icl-rocketry/Ricardo-Gridfins/gridfins/gridfins.kicad_pcb

## KiCad design gridfins/gridfins.kicad_pcb (2026-08-16)

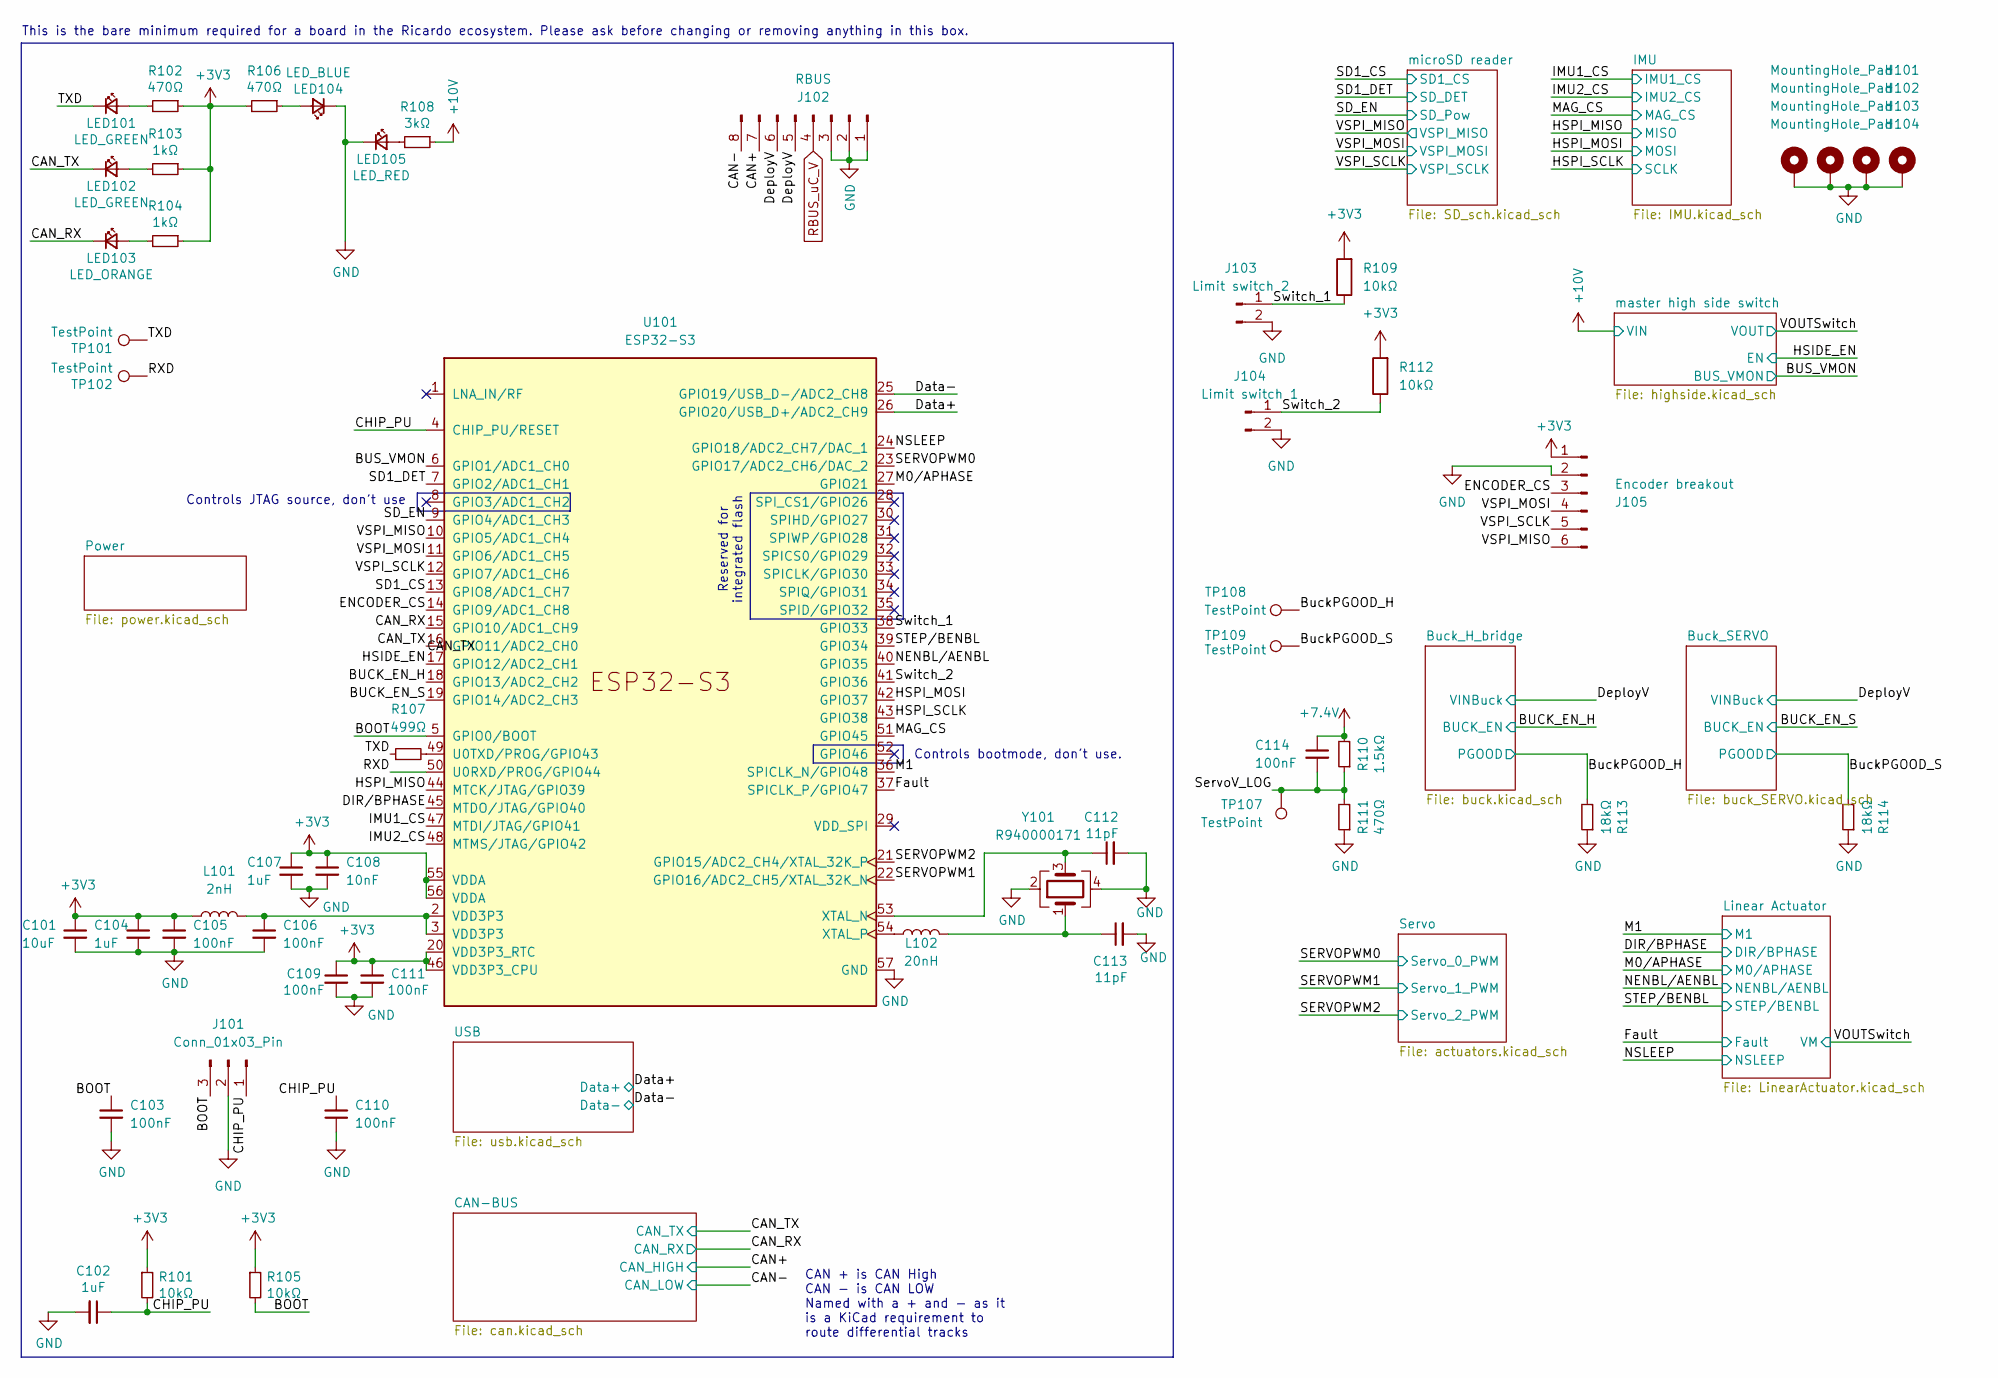
[picture p1: schematic gridfins.kicad_sch]

Parts:
C101: 10uF; C_0402_1005Metric
C102, C104, C107: 1uF; C_0402_1005Metric
C103, C105, C106, C109, C110, C111, C114: 100nF; C_0402_1005Metric
C108: 10nF; C_0402_1005Metric
C112, C113: 11pF; C_0402_1005Metric
H101, H102, H103, H104: MountingHole_Pad; MountingHole_3.2mm_M3_DIN965_Pad
J101: Conn_01x03_Pin; PinHeader_1x03_P1.00mm_Vertical
J102: RBUS; Molex_Mini-Fit_Jr_5569-08A2_2x04_P4.20mm_Horizontal
J103: Limit switch 2; PinHeader_1x02_P2.54mm_Vertical
J104: Limit switch 1; PinHeader_1x02_P2.54mm_Vertical
J105: Encoder breakout; PinHeader_2x03_P2.54mm_Vertical
L101: 2nH; L_0402_1005Metric
L102: 20nH; L_0402_1005Metric
LED101, LED102: LED_GREEN; LED_0402_1005Metric
LED103: LED_ORANGE; LED_0402_1005Metric
LED104: LED_BLUE; LED_0402_1005Metric
LED105: LED_RED; LED_0402_1005Metric
R101, R105, R109, R112: 10kΩ; R_0402_1005Metric
R102, R106, R111: 470Ω; R_0402_1005Metric
R103, R104: 1kΩ; R_0402_1005Metric
R107: 499Ω; R_0402_1005Metric
R108: 3kΩ; R_0402_1005Metric
R110: 1.5kΩ; R_0402_1005Metric
R113, R114: 18kΩ; R_0402_1005Metric
TP101, TP102, TP107, TP108, TP109: TestPoint; TestPoint_Pad_D1.0mm
U101: ESP32-S3; QFN40P700X700X90-57N
Y101: R940000171; Crystal_SMD_2016-4Pin_2.0x1.6mm

Connections:
+3V3: C101.1, C104.1, C105.1, C107.1, C108.1, C109.1, C111.1, J105.1, L101.1, R101.1, R102.1, R103.1, R104.1, R105.1, R106.2, R109.2, R112.2, U101.20 (VDD3P3_RTC), U101.46 (VDD3P3_CPU), U101.55 (VDDA), U101.56 (VDDA); also elsewhere on the board
+7.4V: C114.1, R110.2; also elsewhere on the board
+10V: R108.1; also elsewhere on the board
/BOOT: C103.1, J101.3, R105.2, U101.5 (GPIO0/BOOT)
/BUCK_EN_H: U101.18 (GPIO13/ADC2_CH2); also elsewhere on the board
/BUCK_EN_S: U101.19 (GPIO14/ADC2_CH3); also elsewhere on the board
/BUS_VMON: U101.6 (GPIO1/ADC1_CH0); also elsewhere on the board
/BuckPGOOD_H: R113.2, TP108.1 (1_1); also elsewhere on the board
/BuckPGOOD_S: R114.2, TP109.1 (1_1); also elsewhere on the board
/CAN+: J102.7; also elsewhere on the board
/CAN-: J102.8; also elsewhere on the board
/CAN_RX: LED103.1 (K), U101.15 (GPIO10/ADC1_CH9); also elsewhere on the board
/CAN_TX: LED102.1 (K), U101.16 (GPIO11/ADC2_CH0); also elsewhere on the board
/CHIP_PU: C102.1, C110.2, J101.1, R101.2, U101.4 (CHIP_PU/RESET)
/DIR/BPHASE: U101.45 (MTDO/JTAG/GPIO40); also elsewhere on the board
/Data+: U101.26 (GPIO20/USB_D+/ADC2_CH9); also elsewhere on the board
/Data-: U101.25 (GPIO19/USB_D-/ADC2_CH8); also elsewhere on the board
/DeployV: J102.5, J102.6; also elsewhere on the board
/ENCODER_CS: J105.3, U101.14 (GPIO9/ADC1_CH8)
/Fault: U101.37 (SPICLK_P/GPIO47); also elsewhere on the board
/HSIDE_EN: U101.17 (GPIO12/ADC2_CH1); also elsewhere on the board
/HSPI_MISO: U101.44 (MTCK/JTAG/GPIO39); also elsewhere on the board
/HSPI_MOSI: U101.42 (GPIO37); also elsewhere on the board
/HSPI_SCLK: U101.43 (GPIO38); also elsewhere on the board
/IMU1_CS: U101.47 (MTDI/JTAG/GPIO41); also elsewhere on the board
/IMU2_CS: U101.48 (MTMS/JTAG/GPIO42); also elsewhere on the board
/M0/APHASE: U101.27 (GPIO21); also elsewhere on the board
/M1: U101.36 (SPICLK_N/GPIO48); also elsewhere on the board
/MAG_CS: U101.51 (GPIO45); also elsewhere on the board
/NENBL/AENBL: U101.40 (GPIO35); also elsewhere on the board
/NSLEEP: U101.24 (GPIO18/ADC2_CH7/DAC_1); also elsewhere on the board
/RXD: TP102.1 (1_1), U101.50 (U0RXD/PROG/GPIO44)
/SD1_CS: U101.13 (GPIO8/ADC1_CH7); also elsewhere on the board
/SD1_DET: U101.7 (GPIO2/ADC1_CH1); also elsewhere on the board
/SD_EN: U101.9 (GPIO4/ADC1_CH3); also elsewhere on the board
/SERVOPWM0: U101.23 (GPIO17/ADC2_CH6/DAC_2); also elsewhere on the board
/SERVOPWM1: U101.22 (GPIO16/ADC2_CH5/XTAL_32K_N); also elsewhere on the board
/SERVOPWM2: U101.21 (GPIO15/ADC2_CH4/XTAL_32K_P); also elsewhere on the board
/STEP/BENBL: U101.39 (GPIO34); also elsewhere on the board
/ServoV_LOG: C114.2, R110.1, R111.2, TP107.1 (1_1)
/Switch_1: J103.1, R109.1, U101.38 (GPIO33)
/Switch_2: J104.1, R112.1, U101.41 (GPIO36)
/TXD: LED101.1 (K), R107.1, TP101.1 (1_1)
/VSPI_MISO: J105.6, U101.10 (GPIO5/ADC1_CH4); also elsewhere on the board
/VSPI_MOSI: J105.4, U101.11 (GPIO6/ADC1_CH5); also elsewhere on the board
/VSPI_SCLK: J105.5, U101.12 (GPIO7/ADC1_CH6); also elsewhere on the board
GND: C101.2, C102.2, C103.2, C104.2, C105.2, C106.2, C107.2, C108.2, C109.2, C110.1, C111.2, C112.2, C113.2, H101.1 (1_1), H102.1 (1_1), H103.1 (1_1), H104.1 (1_1), J101.2, J102.1, J102.2, J102.3, J103.2, J104.2, J105.2, LED104.1 (K), LED105.1 (K), R111.1, R113.1, R114.1, U101.57 (GND), Y101.2, Y101.4; also elsewhere on the board
unnamed: C106.1, L101.2, U101.2 (VDD3P3), U101.3 (VDD3P3)
unnamed: C113.1, L102.2, Y101.1
unnamed: LED101.2 (A), R102.2
unnamed: LED102.2 (A), R103.2
unnamed: LED103.2 (A), R104.2
unnamed: LED104.2 (A), R106.1
unnamed: LED105.2 (A), R108.2
unnamed: R107.2, U101.49 (U0TXD/PROG/GPIO43)
unnamed: C112.1, U101.53 (XTAL_N), Y101.3
unnamed: L102.1, U101.54 (XTAL_P)
RBUS_uC_V: J102.4; also elsewhere on the board

Notes on the sheet:
Controls bootmode, don't use.
This is the bare minimum required for a board in the Ricardo ecosystem. Please ask before changing or removing anything in this box.
CAN + is CAN High CAN - is CAN LOW Named with a + and - as it is a KiCad requirement to route differential tracks
Controls JTAG source, don't use
Reserved for integrated flash

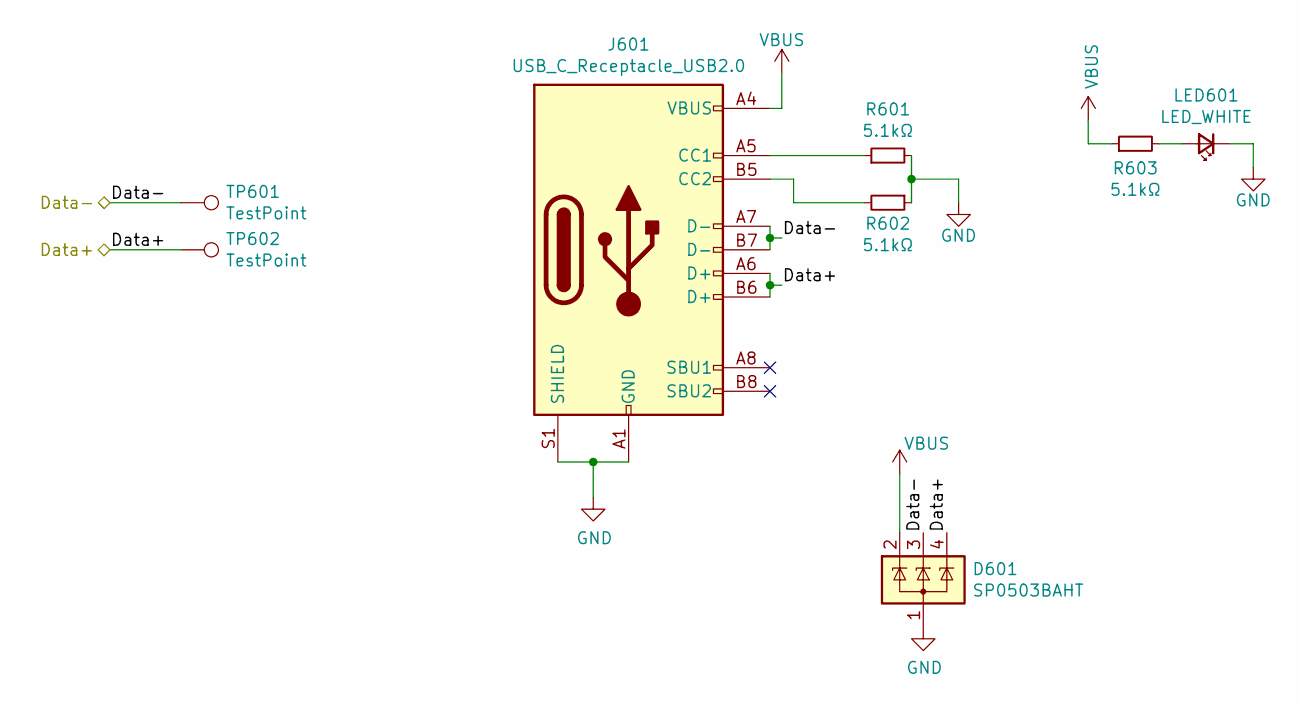
[picture p2: schematic usb.kicad_sch]

Parts:
D601: SP0503BAHT; SOT-143
J601: USB_C_Receptacle_USB2.0; USB_C_Receptacle_Palconn_UTC16-G
LED601: LED_WHITE; LED_0402_1005Metric
R601, R602, R603: 5.1kΩ; R_0402_1005Metric
TP601, TP602: TestPoint; TestPoint_Pad_D1.0mm

Connections:
/Data+: D601.4 (K), J601.A6 (D+), J601.B6 (D+), TP602.1 (1_1); also elsewhere on the board
/Data-: D601.3 (K), J601.A7 (D-), J601.B7 (D-), TP601.1 (1_1); also elsewhere on the board
GND: D601.1 (A), J601.A1 (GND), J601.A12 (GND), J601.B1 (GND), J601.B12 (GND), J601.S1 (SHIELD), LED601.1 (K), R601.2, R602.1; also elsewhere on the board
unnamed: J601.A5 (CC1), R601.1
unnamed: J601.B5 (CC2), R602.2
unnamed: LED601.2 (A), R603.2
VBUS: D601.2 (K), J601.A4 (VBUS), J601.A9 (VBUS), J601.B4 (VBUS), J601.B9 (VBUS), R603.1; also elsewhere on the board

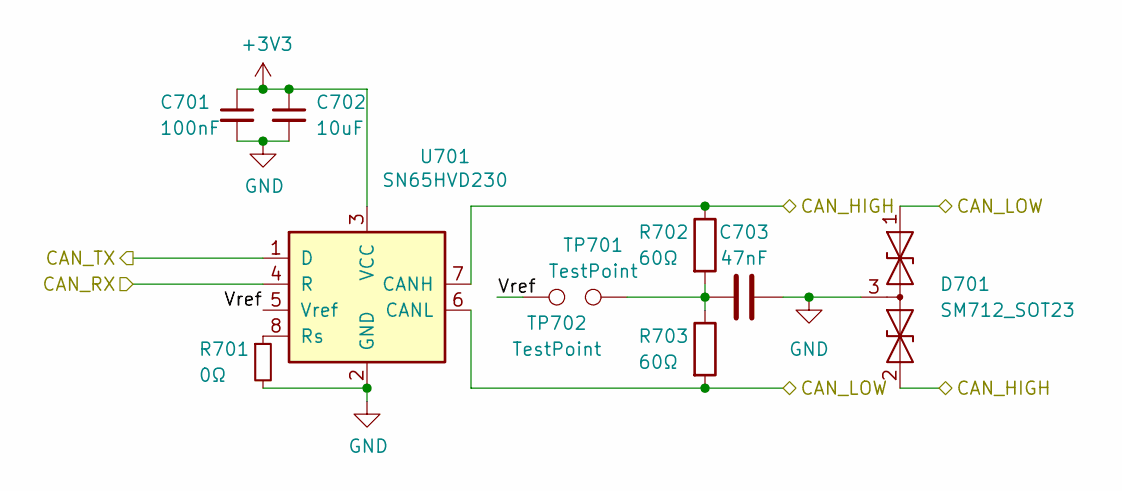
[picture p3: schematic can.kicad_sch]

Parts:
C701: 100nF; C_0402_1005Metric
C702: 10uF; C_0402_1005Metric
C703: 47nF; C_0402_1005Metric
D701: SM712_SOT23; SOT-23
R701: 0Ω; R_0603_1608Metric
R702, R703: 60Ω; R_0603_1608Metric
TP701, TP702: TestPoint
U701: SN65HVD230; SOIC-8_3.9x4.9mm_P1.27mm

Connections:
+3V3: C701.1, C702.1, U701.3 (VCC); also elsewhere on the board
/CAN+: D701.2 (A2), R702.1, U701.7 (CANH); also elsewhere on the board
/CAN-: D701.1 (A1), R703.2, U701.6 (CANL); also elsewhere on the board
/CAN-BUS/Vref: TP702.1 (1_1), U701.5 (Vref)
/CAN_RX: U701.4 (R); also elsewhere on the board
/CAN_TX: U701.1 (D); also elsewhere on the board
GND: C701.2, C702.2, C703.2, D701.3 (common), R701.2, U701.2 (GND); also elsewhere on the board
unnamed: C703.1, R702.2, R703.1, TP701.1 (1_1)
unnamed: R701.1, U701.8 (Rs)

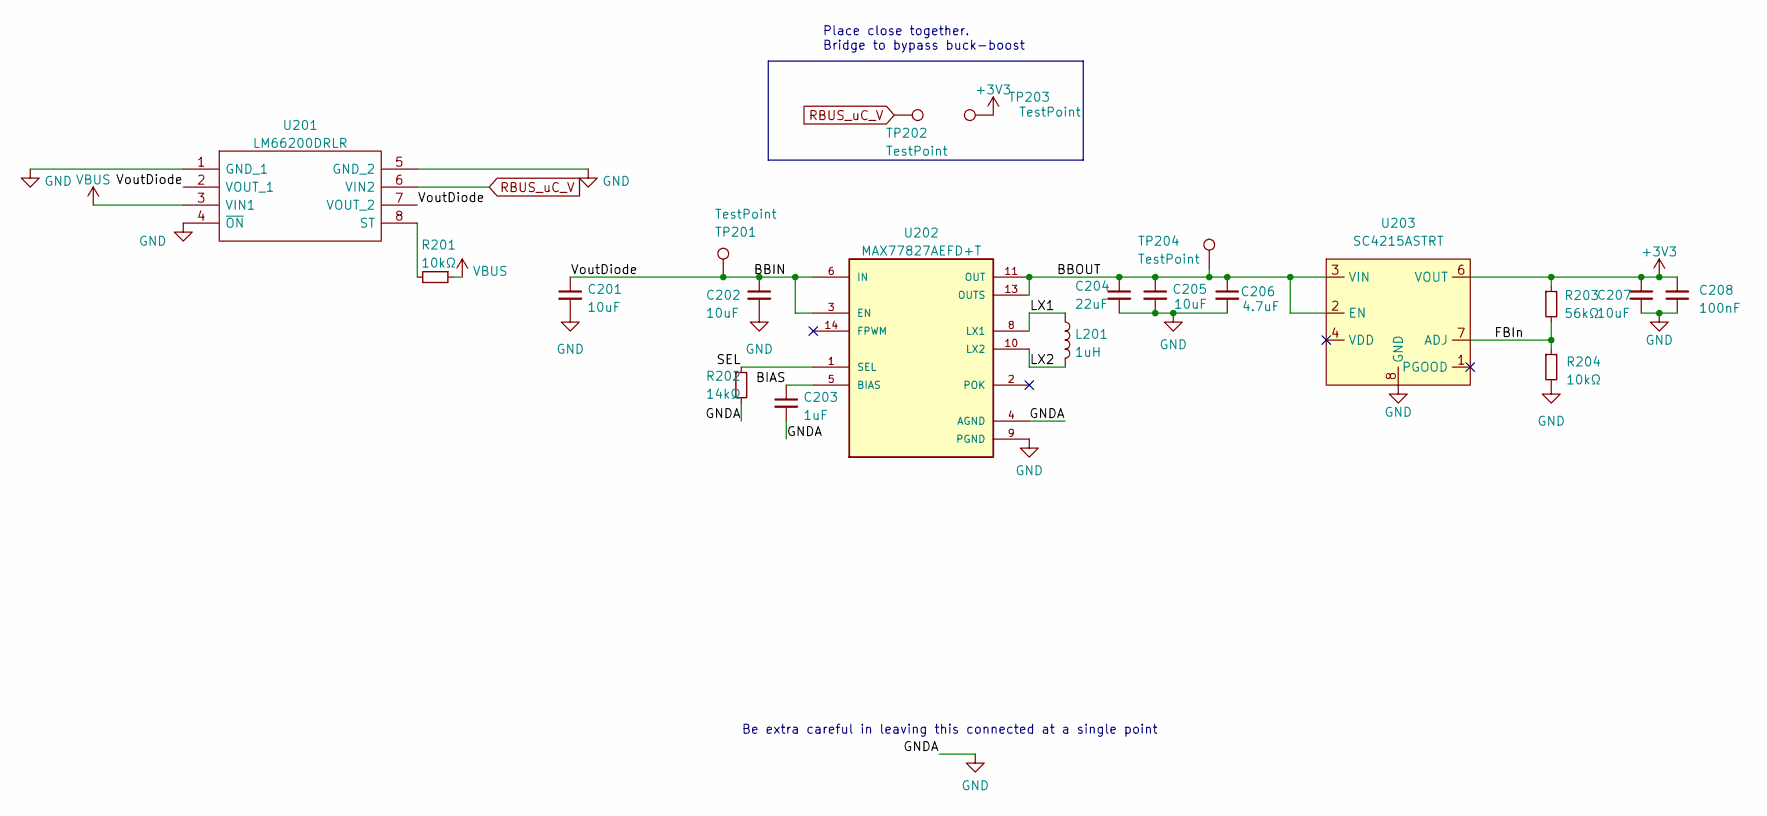
[picture p4: schematic power.kicad_sch]

Parts:
C201, C205, C207: 10uF; C_0402_1005Metric
C202: 10uF; C_0603_1608Metric
C203: 1uF; C_0402_1005Metric
C204: 22uF; C_0603_1608Metric
C206: 4.7uF; C_0402_1005Metric
C208: 100nF; C_0402_1005Metric
L201: 1uH; L_0805_2012Metric
R201, R204: 10kΩ; R_0402_1005Metric
R202: 14kΩ; R_0402_1005Metric
R203: 56kΩ; R_0402_1005Metric
TP201, TP202, TP203, TP204: TestPoint; TestPoint_Pad_D1.5mm
U201: LM66200DRLR; SOTFL50P160X60-8N; Manufacturer_Part_Number LM66200DRLR; Mouser Part Number 595-LM66200DRLR
U202: MAX77827AEFD+T; CONV_MAX77827AEFD+T; PARTREV B
U203: SC4215ASTRT; SOIC127P599X175-9N

Connections:
+3V3: C207.2, C208.2, R203.1, TP203.1 (1_1), U203.6 (VOUT); also elsewhere on the board
/Power/BBIN: C201.1, C202.1, TP201.1 (1_1), U201.2 (VOUT_1), U201.7 (VOUT_2), U202.3 (EN), U202.6 (IN)
/Power/BBOUT: C204.1, C205.1, C206.1, TP204.1 (1_1), U202.11 (OUT), U202.13 (OUTS), U203.2 (EN), U203.3 (VIN)
/Power/BIAS: C203.1, U202.5 (BIAS)
/Power/FBIn: R203.2, R204.1, U203.7 (ADJ)
/Power/LX1: L201.1, U202.8 (LX1)
/Power/LX2: L201.2, U202.10 (LX2)
/Power/SEL: R202.1, U202.1 (SEL)
GND: C201.2, C202.2, C203.2, C204.2, C205.2, C206.2, C207.1, C208.1, R202.2, R204.2, U201.1 (GND_1), U201.4 (~ON), U201.5 (GND_2), U202.4 (AGND), U202.9 (PGND), U203.8 (GND), U203.9 (GND); also elsewhere on the board
unnamed: R201.2, U201.8 (ST)
RBUS_uC_V: TP202.1 (1_1), U201.6 (VIN2); also elsewhere on the board
VBUS: R201.1, U201.3 (VIN1); also elsewhere on the board

Notes on the sheet:
Place close together. Bridge to bypass buck-boost
Be extra careful in leaving this connected at a single point

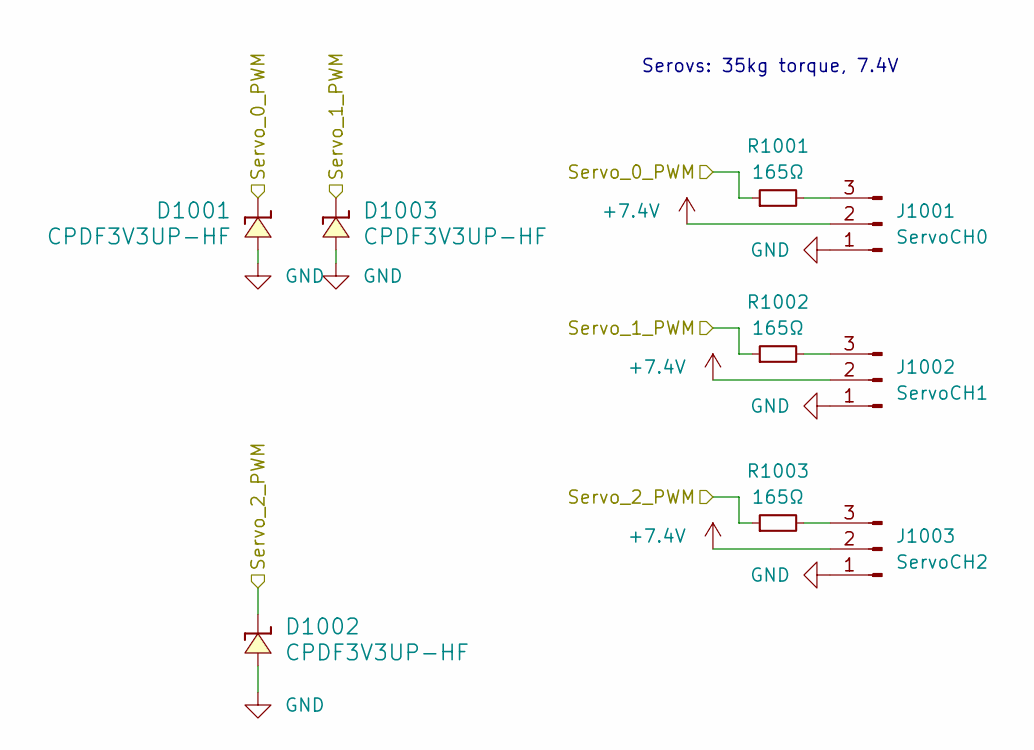
[picture p5: schematic actuators.kicad_sch]

Parts:
D1001, D1002, D1003: CPDF3V3UP-HF; CPD
J1001: ServoCH0; Molex_Nano-Fit_105313-xx03_1x03_P2.50mm_Horizontal
J1002: ServoCH1; Molex_Nano-Fit_105313-xx03_1x03_P2.50mm_Horizontal
J1003: ServoCH2; Molex_Nano-Fit_105313-xx03_1x03_P2.50mm_Horizontal
R1001, R1002, R1003: 165Ω; R_0402_1005Metric; MPN RK73H1ETTP1650F

Connections:
+7.4V: J1001.2, J1002.2, J1003.2; also elsewhere on the board
/SERVOPWM0: D1001.2, R1001.1; also elsewhere on the board
/SERVOPWM1: D1003.2, R1002.1; also elsewhere on the board
/SERVOPWM2: D1002.2, R1003.1; also elsewhere on the board
GND: D1001.1, D1002.1, D1003.1, J1001.1, J1002.1, J1003.1; also elsewhere on the board
unnamed: J1001.3, R1001.2
unnamed: J1002.3, R1002.2
unnamed: J1003.3, R1003.2

Notes on the sheet:
Serovs: 35kg torque, 7.4V

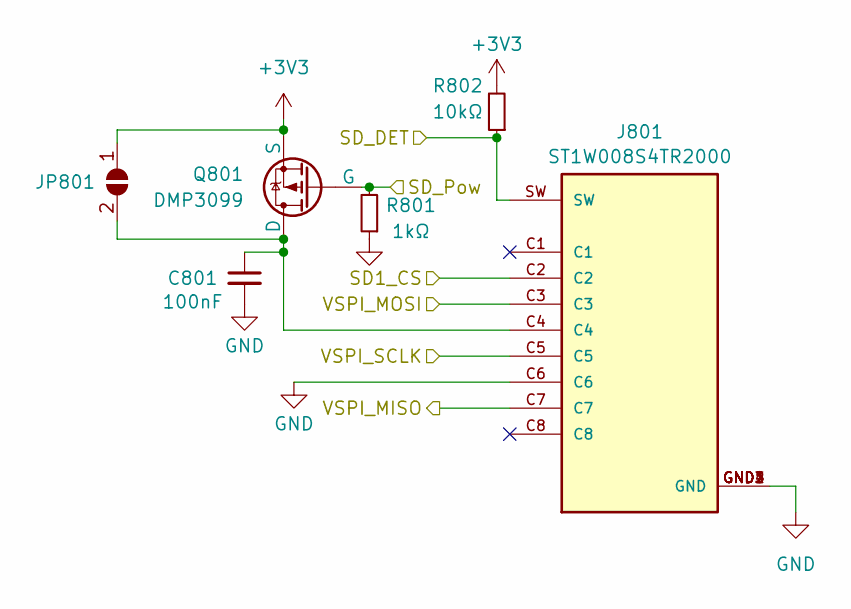
[picture p6: schematic SD_sch.kicad_sch]

Parts:
C801: 100nF; C_0402_1005Metric
J801: ST1W008S4TR2000; JAE_ST1W008S4TR2000; PARTREV 1
JP801: SolderJumper_2_Open; SmallerSolderJP
Q801: DMP3099; SOT-23; MPN DMP3099L
R801: 1kΩ; R_0402_1005Metric
R802: 10kΩ; R_0402_1005Metric

Connections:
+3V3: JP801.1 (A), Q801.3 (S), R802.2; also elsewhere on the board
/SD1_CS: J801.C2; also elsewhere on the board
/SD1_DET: J801.SW, R802.1; also elsewhere on the board
/SD_EN: Q801.2 (G), R801.2; also elsewhere on the board
/VSPI_MISO: J801.C7; also elsewhere on the board
/VSPI_MOSI: J801.C3; also elsewhere on the board
/VSPI_SCLK: J801.C5; also elsewhere on the board
GND: C801.2, J801.C6, J801.GND1 (GND), J801.GND2 (GND), J801.GND3 (GND), J801.GND4 (GND), R801.1; also elsewhere on the board
unnamed: C801.1, J801.C4, JP801.2 (B), Q801.1 (D)

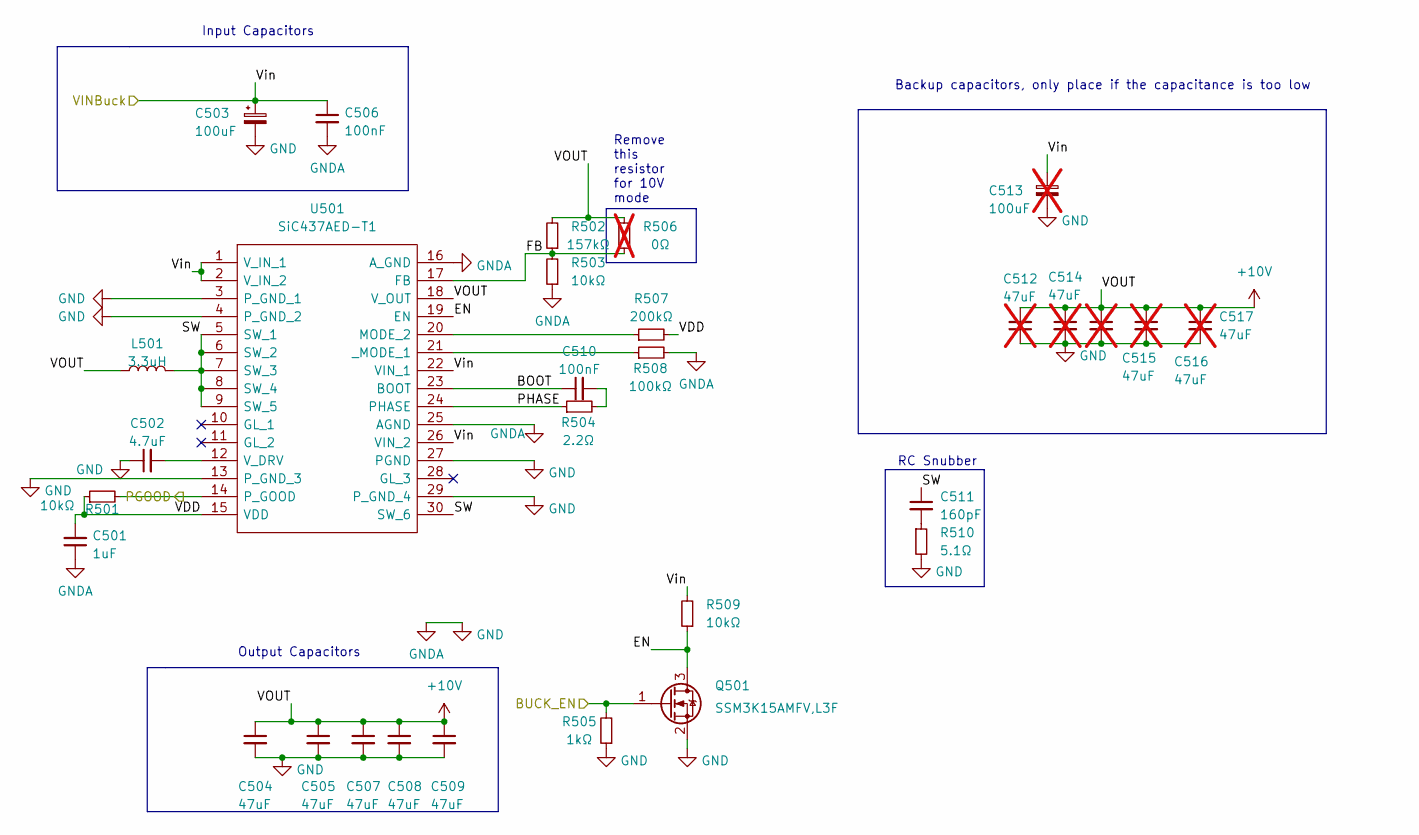
[picture p7: schematic buck.kicad_sch]

Parts:
C501: 1uF; C_0402_1005Metric
C502: 4.7uF; C_0402_1005Metric
C503: 100uF; CP_EIA-7360-38_Kemet-E; MPN T52M1107M035C0100
C504, C505, C507, C508, C509: 47uF; C_1206_3216Metric
C506, C510: 100nF; C_0402_1005Metric
C511: 160pF; C_0603_1608Metric
C512, C514, C515, C516, C517: 47uF; C_1206_3216Metric; not fitted
C513: 100uF; CP_EIA-7360-38_Kemet-E; MPN T52M1107M035C0100; not fitted
L501: 3.3uH; WE-XHMI_7070; MPN SPM10065VT-3R3M-D
Q501: SSM3K15AMFV,L3F; SOT-723
R501, R503, R509: 10kΩ; R_0402_1005Metric
R502: 157kΩ; R_0402_1005Metric; MPN ERJ-2RKF1133X
R504: 2.2Ω; R_0402_1005Metric
R505: 1kΩ; R_0402_1005Metric
R506: 0Ω; R_0402_1005Metric; MPN ERJ-2RKF4423X; not fitted
R507: 200kΩ; R_0402_1005Metric
R508: 100kΩ; R_0402_1005Metric
R510: 5.1Ω; R_0603_1608Metric
U501: SiC437AED-T1; SiC437BEDT1GE3; Manufacturer_Part_Number SiC437BED-T1-GE3; Mouser Part Number 78-SIC437BED-T1-GE3

Connections:
+10V: C504.1, C505.1, C507.1, C508.1, C509.1, C512.2, C514.1, C515.1, C516.1, C517.1, L501.2, R502.2, R506.2, U501.18 (V_OUT); also elsewhere on the board
/BUCK_EN_H: Q501.1 (G), R505.2; also elsewhere on the board
/BuckPGOOD_H: R501.2, U501.14 (P_GOOD); also elsewhere on the board
/Buck_H_bridge/BOOT: C510.1, U501.23 (BOOT)
/Buck_H_bridge/EN: Q501.3 (D), R509.1, U501.19 (EN)
/Buck_H_bridge/FB: R502.1, R503.2, R506.1, U501.17 (FB)
/Buck_H_bridge/PHASE: R504.1, U501.24 (PHASE)
/Buck_H_bridge/SW: C511.1, L501.1, U501.5 (SW_1), U501.6 (SW_2), U501.7 (SW_3), U501.8 (SW_4), U501.9 (SW_5), U501.30 (SW_6)
/Buck_H_bridge/VDD: C501.2, R501.1, R507.2, U501.15 (VDD)
/DeployV: C503.1, C506.1, C513.1, R509.2, U501.1 (V_IN_1), U501.2 (V_IN_2), U501.22 (VIN_1), U501.26 (VIN_2); also elsewhere on the board
GND: C501.1, C502.1, C503.2, C504.2, C505.2, C506.2, C507.2, C508.2, C509.2, C512.1, C513.2, C514.2, C515.2, C516.2, C517.2, Q501.2 (S), R503.1, R505.1, R508.2, R510.2, U501.3 (P_GND_1), U501.4 (P_GND_2), U501.13 (P_GND_3), U501.16 (A_GND), U501.25 (AGND), U501.27 (PGND), U501.29 (P_GND_4); also elsewhere on the board
unnamed: C510.2, R504.2
unnamed: C511.2, R510.1
unnamed: R507.1, U501.20 (MODE_2)
unnamed: C502.2, U501.12 (V_DRV)
unnamed: R508.1, U501.21 (_MODE_1)

Notes on the sheet:
Output Capacitors
RC Snubber
Input Capacitors
Backup capacitors, only place if the capacitance is too low
Remove this resistor for 10V mode

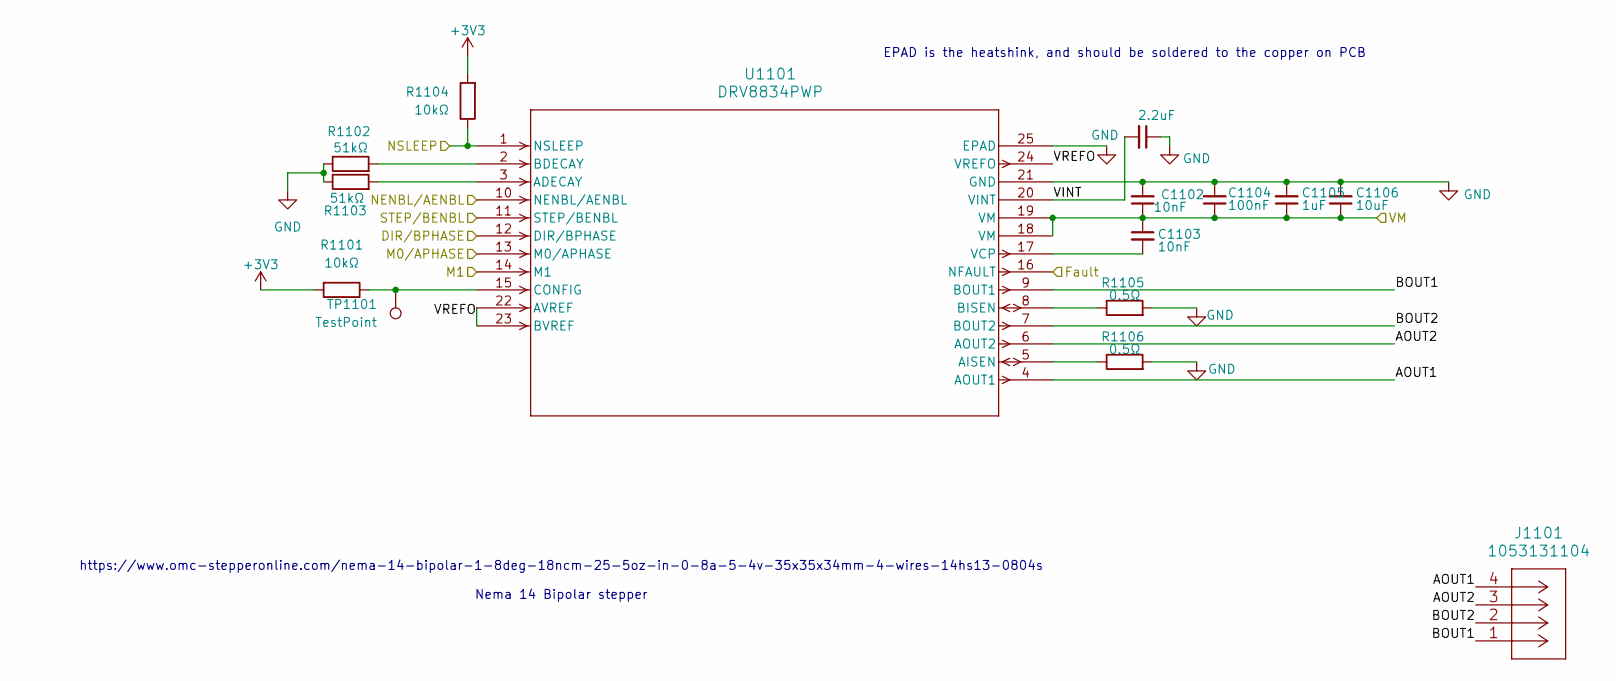
[picture p8: schematic LinearActuator.kicad_sch]

Parts:
C1101: 2.2uF; C_0402_1005Metric
C1102, C1103: 10nF; C_0402_1005Metric
C1104: 100nF; C_0402_1005Metric
C1105: 1uF; C_0402_1005Metric
C1106: 10uF; C_0805_2012Metric
J1101: 1053131104; Molex_Nano-Fit_105313-xx04_1x04_P2.50mm_Horizontal
R1101, R1104: 10kΩ; R_0402_1005Metric
R1102, R1103: 51kΩ; R_0402_1005Metric
R1105, R1106: 0.5Ω; R_2512_6332Metric
TP1101: TestPoint; TestPoint_Pad_D1.0mm
U1101: DRV8834PWP; PWP_24

Connections:
+3V3: R1101.2, R1104.2; also elsewhere on the board
/DIR/BPHASE: U1101.12 (DIR/BPHASE); also elsewhere on the board
/Fault: U1101.16 (NFAULT); also elsewhere on the board
/Linear Actuator/AOUT1: J1101.4, U1101.4 (AOUT1)
/Linear Actuator/AOUT2: J1101.3, U1101.6 (AOUT2)
/Linear Actuator/BOUT1: J1101.1, U1101.9 (BOUT1)
/Linear Actuator/BOUT2: J1101.2, U1101.7 (BOUT2)
/Linear Actuator/VINT: C1101.2, U1101.20 (VINT)
/Linear Actuator/VREFO: U1101.22 (AVREF), U1101.23 (BVREF), U1101.24 (VREFO)
/M0/APHASE: U1101.13 (M0/APHASE); also elsewhere on the board
/M1: U1101.14 (M1); also elsewhere on the board
/NENBL/AENBL: U1101.10 (NENBL/AENBL); also elsewhere on the board
/NSLEEP: R1104.1, U1101.1 (NSLEEP); also elsewhere on the board
/STEP/BENBL: U1101.11 (STEP/BENBL); also elsewhere on the board
/VOUTSwitch: C1102.1, C1103.1, C1104.1, C1105.1, C1106.1, U1101.18 (VM), U1101.19 (VM); also elsewhere on the board
GND: C1101.1, C1102.2, C1104.2, C1105.2, C1106.2, R1102.1, R1103.1, R1105.2, R1106.2, U1101.21 (GND), U1101.25 (EPAD); also elsewhere on the board
unnamed: R1103.2, U1101.3 (ADECAY)
unnamed: R1106.1, U1101.5 (AISEN)
unnamed: R1102.2, U1101.2 (BDECAY)
unnamed: R1105.1, U1101.8 (BISEN)
unnamed: R1101.1, TP1101.1 (1_1), U1101.15 (CONFIG)
unnamed: C1103.2, U1101.17 (VCP)

Notes on the sheet:
https://www.omc-stepperonline.com/nema-14-bipolar-1-8deg-18ncm-25-5oz-in-0-8a-5-4v-35x35x34mm-4-wires-14hs13-0804s Nema 14 Bipolar stepper
EPAD is the heatshink, and should be soldered to the copper on PCB

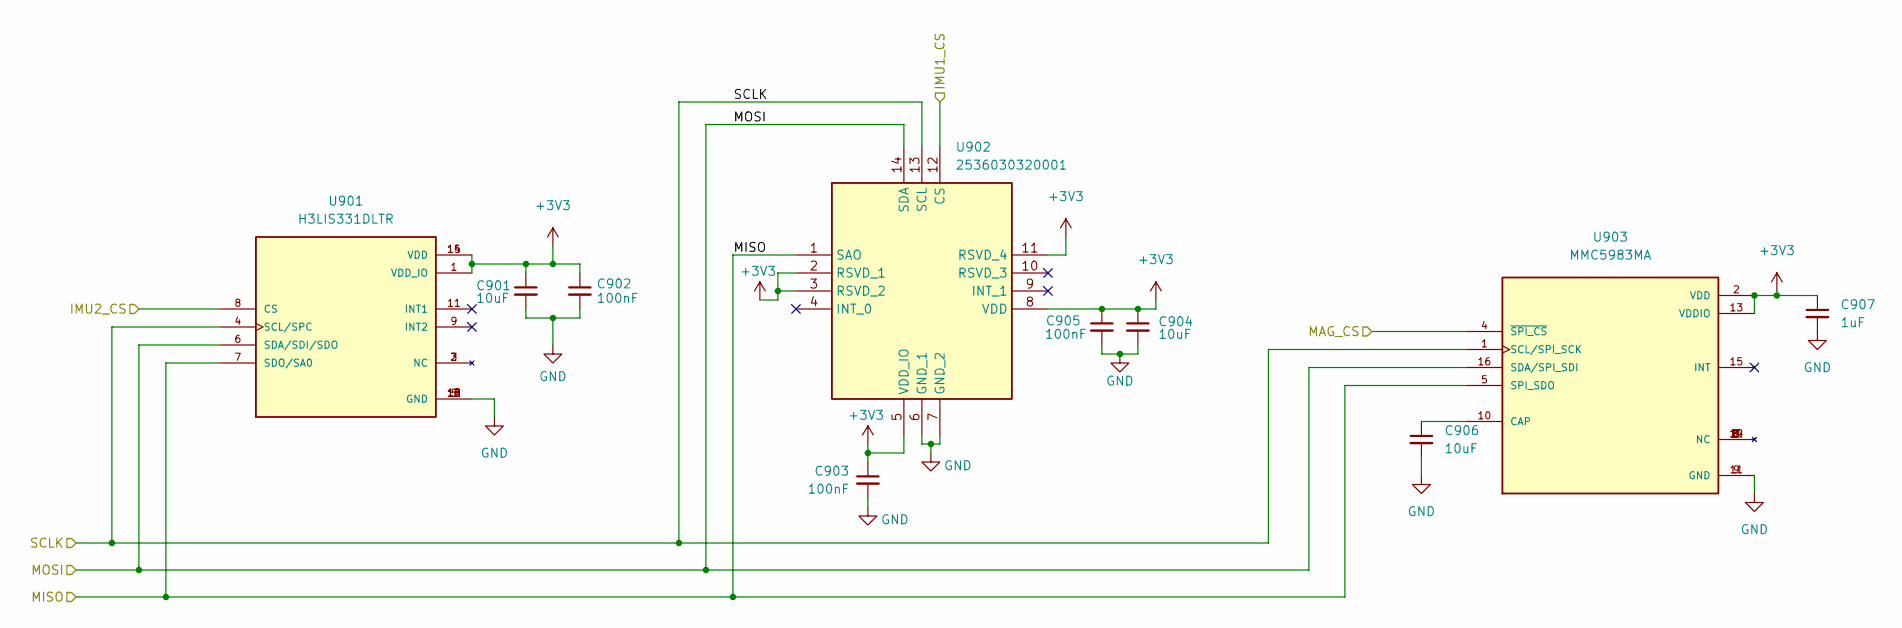
[picture p9: schematic IMU.kicad_sch]

Parts:
C901, C904, C906: 10uF; C_0402_1005Metric
C902, C903, C905: 100nF; C_0402_1005Metric
C907: 1uF; C_0402_1005Metric
U901: H3LIS331DLTR; QFN300X300X100-16N; PARTREV 2
U902: 2536030320001; Mouser Part Number 710-2536030320001
U903: MMC5983MA; PQFN50P300X300X100-16N; PARTREV A

Connections:
+3V3: C901.1, C902.1, C903.1, C904.1, C905.1, C907.1, U901.1 (VDD_IO), U901.14 (VDD), U901.15 (VDD), U902.2 (RSVD_1), U902.3 (RSVD_2), U902.5 (VDD_IO), U902.8 (VDD), U902.11 (RSVD_4), U903.2 (VDD), U903.13 (VDDIO); also elsewhere on the board
/HSPI_MISO: U901.7 (SDO/SA0), U902.1 (SAO), U903.5 (SPI_SDO); also elsewhere on the board
/HSPI_MOSI: U901.6 (SDA/SDI/SDO), U902.14 (SDA), U903.16 (SDA/SPI_SDI); also elsewhere on the board
/HSPI_SCLK: U901.4 (SCL/SPC), U902.13 (SCL), U903.1 (SCL/SPI_SCK); also elsewhere on the board
/IMU1_CS: U902.12 (CS); also elsewhere on the board
/IMU2_CS: U901.8 (CS); also elsewhere on the board
/MAG_CS: U903.4 (~SPI_CS); also elsewhere on the board
GND: C901.2, C902.2, C903.2, C904.2, C905.2, C906.2, C907.2, U901.5 (GND), U901.10 (GND), U901.12 (GND), U901.13 (GND), U901.16 (GND), U902.6 (GND_1), U902.7 (GND_2), U903.9 (GND), U903.11 (GND); also elsewhere on the board
unnamed: C906.1, U903.10 (CAP)

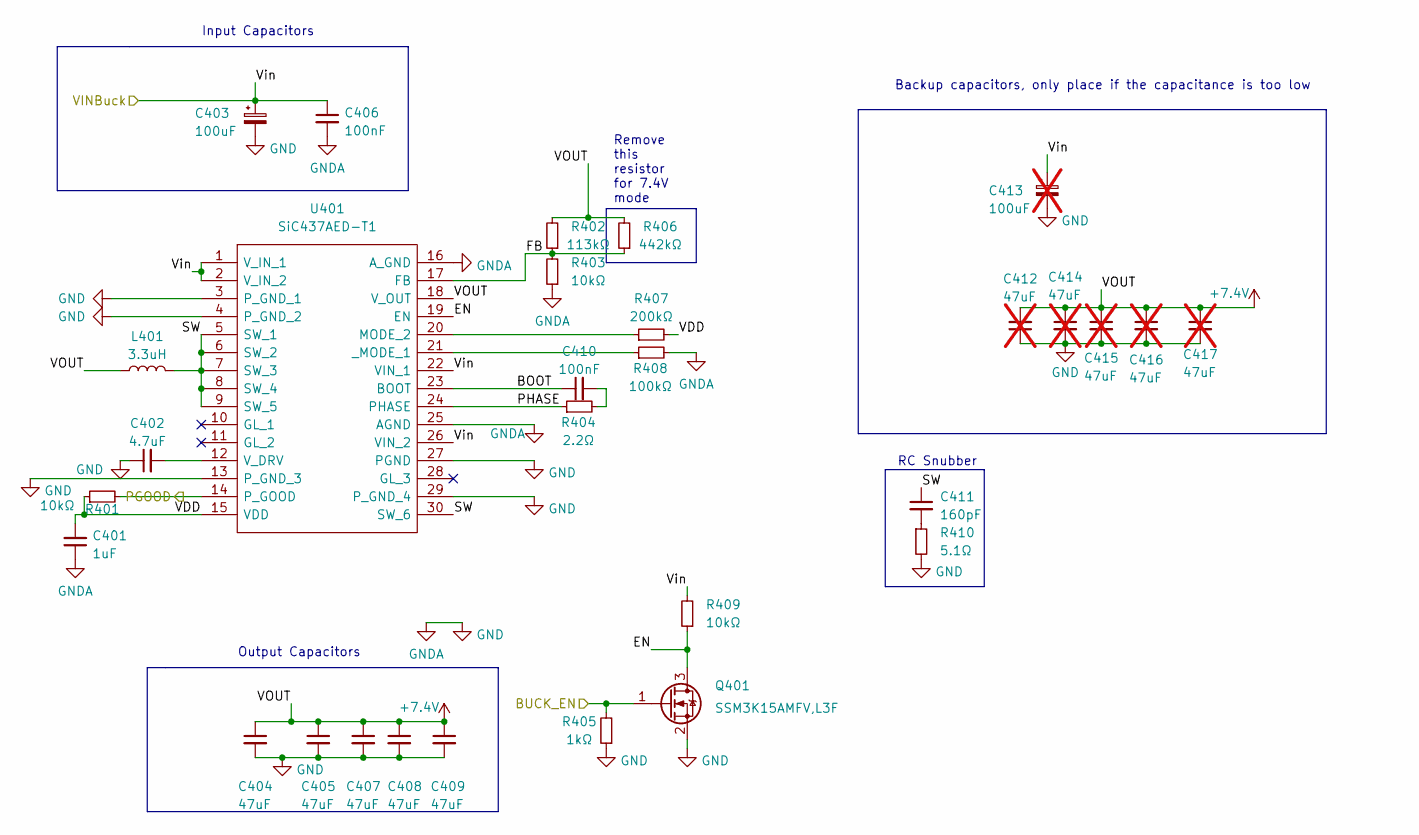
[picture p10: schematic buck_SERVO.kicad_sch]

Parts:
C401: 1uF; C_0402_1005Metric
C402: 4.7uF; C_0402_1005Metric
C403: 100uF; CP_EIA-7360-38_Kemet-E; MPN T52M1107M035C0100
C404, C405, C407, C408, C409: 47uF; C_1206_3216Metric
C406, C410: 100nF; C_0402_1005Metric
C411: 160pF; C_0603_1608Metric
C412, C414, C415, C416, C417: 47uF; C_1206_3216Metric; not fitted
C413: 100uF; CP_EIA-7360-38_Kemet-E; MPN T52M1107M035C0100; not fitted
L401: 3.3uH; WE-XHMI_7070; MPN SPM10065VT-3R3M-D
Q401: SSM3K15AMFV,L3F; SOT-723
R401, R403, R409: 10kΩ; R_0402_1005Metric
R402: 113kΩ; R_0402_1005Metric; MPN ERJ-2RKF1133X
R404: 2.2Ω; R_0402_1005Metric
R405: 1kΩ; R_0402_1005Metric
R406: 442kΩ; R_0402_1005Metric; MPN ERJ-2RKF4423X
R407: 200kΩ; R_0402_1005Metric
R408: 100kΩ; R_0402_1005Metric
R410: 5.1Ω; R_0603_1608Metric
U401: SiC437AED-T1; SiC437BEDT1GE3; Manufacturer_Part_Number SiC437BED-T1-GE3; Mouser Part Number 78-SIC437BED-T1-GE3

Connections:
+7.4V: C404.1, C405.1, C407.1, C408.1, C409.1, C412.2, C414.1, C415.1, C416.1, C417.1, L401.2, R402.2, R406.2, U401.18 (V_OUT); also elsewhere on the board
/BUCK_EN_S: Q401.1 (G), R405.2; also elsewhere on the board
/BuckPGOOD_S: R401.2, U401.14 (P_GOOD); also elsewhere on the board
/Buck_SERVO/BOOT: C410.1, U401.23 (BOOT)
/Buck_SERVO/EN: Q401.3 (D), R409.1, U401.19 (EN)
/Buck_SERVO/FB: R402.1, R403.2, R406.1, U401.17 (FB)
/Buck_SERVO/PHASE: R404.1, U401.24 (PHASE)
/Buck_SERVO/SW: C411.1, L401.1, U401.5 (SW_1), U401.6 (SW_2), U401.7 (SW_3), U401.8 (SW_4), U401.9 (SW_5), U401.30 (SW_6)
/Buck_SERVO/VDD: C401.2, R401.1, R407.2, U401.15 (VDD)
/DeployV: C403.1, C406.1, C413.1, R409.2, U401.1 (V_IN_1), U401.2 (V_IN_2), U401.22 (VIN_1), U401.26 (VIN_2); also elsewhere on the board
GND: C401.1, C402.1, C403.2, C404.2, C405.2, C406.2, C407.2, C408.2, C409.2, C412.1, C413.2, C414.2, C415.2, C416.2, C417.2, Q401.2 (S), R403.1, R405.1, R408.2, R410.2, U401.3 (P_GND_1), U401.4 (P_GND_2), U401.13 (P_GND_3), U401.16 (A_GND), U401.25 (AGND), U401.27 (PGND), U401.29 (P_GND_4); also elsewhere on the board
unnamed: C410.2, R404.2
unnamed: C411.2, R410.1
unnamed: R407.1, U401.20 (MODE_2)
unnamed: C402.2, U401.12 (V_DRV)
unnamed: R408.1, U401.21 (_MODE_1)

Notes on the sheet:
Input Capacitors
RC Snubber
Output Capacitors
Backup capacitors, only place if the capacitance is too low
Remove this resistor for 7.4V mode
