icl-rocketry/Ricardo-Gridfins/gridfins/gridfins.kicad_pcb

## KiCad design gridfins/gridfins.kicad_pcb (continued)

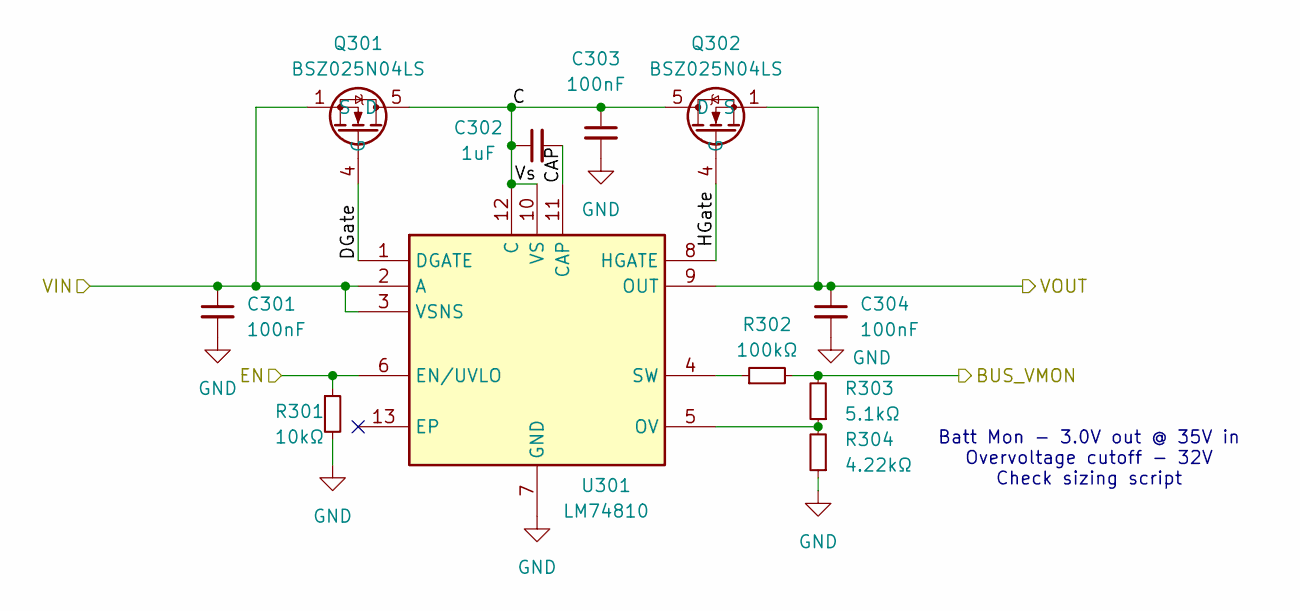
[picture p11: schematic highside.kicad_sch]

Parts:
C301, C304: 100nF; C_0402_1005Metric
C302: 1uF; C_0402_1005Metric; Voltage Rating DC 50V; MPN GRT188R61H225KE13D
C303: 100nF; C_0603_1608Metric
Q301, Q302: BSZ025N04LS; Manufacturer_Part_Number BSZ025N04LS; Mouser Part Number 726-BSZ025N04LS
R301: 10kΩ; R_0402_1005Metric
R302: 100kΩ; R_0402_1005Metric
R303: 5.1kΩ; R_0402_1005Metric
R304: 4.22kΩ; R_0402_1005Metric
U301: LM74810; SON50P300X300X80-13N-D; Manufacturer_Part_Number LM74810QDRRRQ1; Mouser Part Number 595-LM74810QDRRRQ1

Connections:
+10V: C301.1, Q301.1 (S), Q301.2 (S), Q301.3 (S), Q301.A1 (S), U301.2 (A), U301.3 (VSNS); also elsewhere on the board
/BUS_VMON: R302.2, R303.2; also elsewhere on the board
/HSIDE_EN: R301.1, U301.6 (EN/UVLO); also elsewhere on the board
/VOUTSwitch: C304.1, Q302.1 (S), Q302.2 (S), Q302.3 (S), Q302.A1 (S), U301.9 (OUT); also elsewhere on the board
/master high side switch/C: C302.1, C303.1, Q301.5 (D), Q301.6 (D), Q301.7 (D), Q301.8 (D), Q301.A5 (D), Q302.5 (D), Q302.6 (D), Q302.7 (D), Q302.8 (D), Q302.A5 (D), U301.10 (VS), U301.12 (C)
/master high side switch/CAP: C302.2, U301.11 (CAP)
/master high side switch/DGate: Q301.4 (G), U301.1 (DGATE)
/master high side switch/HGate: Q302.4 (G), U301.8 (HGATE)
GND: C301.2, C303.2, C304.2, R301.2, R304.1, U301.7 (GND); also elsewhere on the board
unnamed: R303.1, R304.2, U301.5 (OV)
unnamed: R302.1, U301.4 (SW)

Notes on the sheet:
Batt Mon - 3.0V out @ 35V in Overvoltage cutoff - 32V Check sizing script

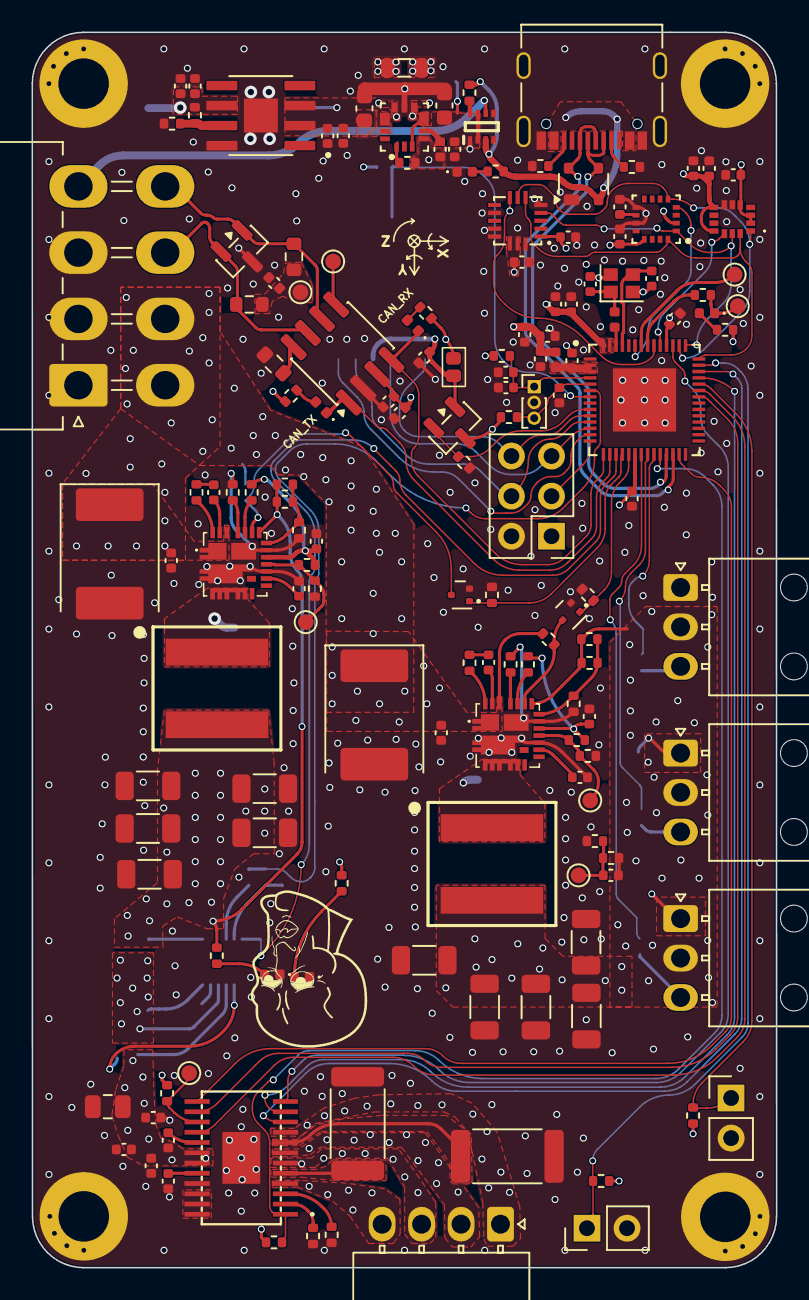
[picture p12: board gridfins.kicad_pcb from above]

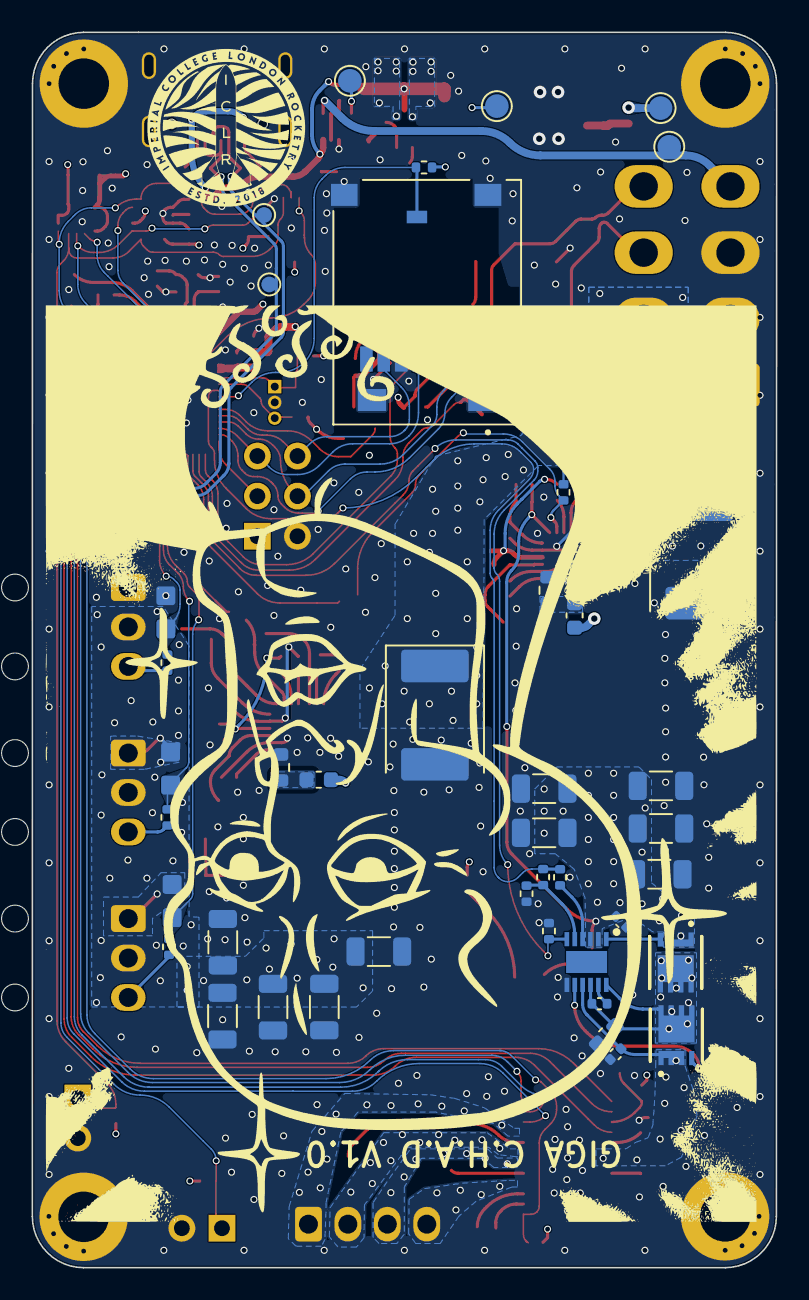
[picture p13: board gridfins.kicad_pcb from below]

Board: 4 copper layers, 47.2 x 78.3 mm, 202 parts (43 on the bottom side), 119 nets.

Other parts of the board:
G**: orientation_marker
LOGO1: ICLR LOGO; iclr_logo_estd2018_10mm
