icl-rocketry/Ricardo-Gridfins/(commit log)

2026-02-03 Initial board setup
    Made an LED. Copied Ricardo-Chad buck converters and servo pwm (and tvs diode)
    - added a third servo and parallel tvs diode circuit
    - sheet references/labels not fully updated yet
    [actuators.kicad_sch, buck.kicad_sch, can.kicad_sch, gridfins.kicad_pcb, gridfins.kicad_sch, power.kicad_sch, usb.kicad_sch]
2026-02-03 update 2
    Renamed repeated resistor names. Changed typo in buck - removing the 442k resistor actually changes Vout to 7.4V not 8.4! We need 7.4V for servos.
    [actuators.kicad_sch, buck.kicad_sch, gridfins.kicad_sch]
2026-02-03 update 3
    added tvs diode chip module for 3rd servo
    added net connection to actuators sheet
    changed 6 to 7.4 label
    [actuators.kicad_sch, buck.kicad_sch, gridfins.kicad_sch]
2026-02-07 Update with Inertial Measurement Unit
    cloned IMU from pickle rick.
    [IMU.kicad_sch, actuators.kicad_sch, gridfins.kicad_pcb, gridfins.kicad_sch]
2026-02-07 forgot to save the file
    [IMU.kicad_sch, LinearActuator.kicad_sch, gridfins.kicad_sch]
2026-02-10 SD card, linear actuator encoders
    Imported microSD reader from Stark
    Added pin connectors and SPI routes for AS5048 magnetic rotary encoder to be used with the linear actuator/brushed motor
    Added test pads for SD reader and encoder chip select
    [LinearActuator.kicad_sch, SD_sch.kicad_sch, actuators.kicad_sch, gridfins.kicad_sch]
2026-02-14 Deployment Power Cut Mechanism
    Employed the master high-side switch from flintandsteel to disable servo and linear actuator power once lower altitude limit reached. This will prevent electrical problems during touchdown:
    Routed power rail 16.8V to switch input. Switch output routed to buck input. When high-side switch is enabled, buck input voltage is pulled down, depowering the servos and linear actuator.
    [buck.kicad_sch, gridfins.kicad_sch, highside.kicad_sch]
2026-02-24 deleted obsolete ICM-20608-G from IMU, added WSEN-ISDS adviced by Jack, a 6 axis IMU. Added footprint and symbol. Yet to finish connections and finish the "application circuit". Added footprint for 6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
    [IMU.kicad_sch, LinearActuator.kicad_sch, gridfins.kicad_pcb]
2026-03-03 IMU replacement
    created symbol and completed operational circuit for the WSEN-IDS 6 axis imu chip. Chip select accessed through the same - IMU1_CS. Need to verify direction of SCL port
    [IMU.kicad_sch]
2026-03-03 Imported Official footprints and symbol
    [IMU.kicad_sch]
2026-03-07 PCB design
    Started drawing fill-out zones and organising the recommended PCB layout for the SiC437, 438 on the buck converter
    [gridfins.kicad_pcb]
2026-05-16 buck PCB
    progress - starting from buck converter STEP 4
    - Rboot ad Cboot placed near the chip and between pin 23 and 24. Both capcitor and resistor of the recommended size 0402
    moved snubber up to top layer
    began to move
    analog components to left side while power components to right of IC
    [IMU.kicad_sch, gridfins.kicad_pcb]
2026-05-20 First Attempt connection of stepper motor driver for linear actuator
    Added connections of driver and 4 pin nano. Added hierarchical labels and connected to GPIO. Current configuration is the INDEX mode
    [LinearActuator.kicad_sch, gridfins.kicad_sch]
2026-05-23 Power distribution rework
    Added missing main power supply voltage to Stepper Motor Driver Board
    Separate Buck converter for servo and linear actuator(stepper motor)
    16.8V -> Buck -> high side switch -> H-bridge -> 10V
    16.8V -> Buck -> Servo -> 7.4V
    [LinearActuator.kicad_sch, buck_SERVO.kicad_sch, gridfins.kicad_sch]
2026-06-06 PCB + schematic updates
    Solved footprint error which prevented PCB from updating
    Deleted old buck converter PCB design (old buck now replaced with 2 for servo and linear acc)
    Moved Snubber and crossed out capacitor network to the backside of board
    Unsure whether if the +10V routing is valid - currently connected via tracers, not planes (may be a problem for current)
    Restructured old pcb which previously had planes associated with no nets (assigned nets to them)
    If current design approved, will proceed to carry out the same design for the servo controlling buck converter.
    [LinearActuator.kicad_sch, buck.kicad_sch, buck_SERVO.kicad_sch, gridfins.kicad_pcb, gridfins.kicad_sch]
2026-06-26 Handoff
    implemented changes advised by Will. Still a bit unsure about how the EPAD should be connected to ground. The PCB design of both buck converters for servo and Hbridge(linear accuator) was completed - but still needs to be reviewed
    [LinearActuator.kicad_sch, buck.kicad_sch, gridfins.kicad_pcb, gridfins.kicad_sch]
2026-08-01 feat: Major changes
    Changes made by Roshan + major adaption from me.
    [gridfins.kicad_pcb]
2026-08-05 feat: Massive changes, board almost ready for review
    [IMU.kicad_sch, LinearActuator.kicad_sch, SD_sch.kicad_sch, actuators.kicad_sch, buck.kicad_sch, buck_SERVO.kicad_sch, can.kicad_sch, gridfins.kicad_pcb]
2026-08-06 feat: A few more changes, mainly fixing copper pours and DRC erros. Still need to change buck inductors to wuerth ones + route end stop switch traces better.
    [gridfins.kicad_pcb]
2026-08-07 feat: Ready for first review, made a mockup name etc
    [gridfins.kicad_pcb]
2026-08-07 feat: Smoothed the traces + fixed some zone issues and disconnected VBUS issue.
    [gridfins.kicad_pcb]
2026-08-16 feat: Post Jack review
    Changed buck inductors to be wuerth. Reduced board footprint. Incorporated review feedback
    [buck.kicad_sch, buck_SERVO.kicad_sch, can.kicad_sch, gridfins.kicad_pcb, gridfins.kicad_sch]
